bkueffle/Talking-clock/(commit log)

2018-11-02 Added LCD object and LCD interrupts
2018-11-04 Added debouncer for the clock setting buttons.
2018-11-06 added mp3 testing file and mandarin/english sound files
    -added mp3testing file
    -added mandarin sound files
    -added english mp3 files used in speech testing (not sure if .wav files will work)
    -included an excel file for keeping track of the sound file names
    [mp3filelabels.xlsx]
2018-11-12 Refactored mp3testingfile.ino into timetomp3.h/.cpp.
    - Created runtime mode changing button.
    - In the middle of making the LCD display characters for each mode during mode switching.
    - The input device still needs to be improved to be less sensitive to loud human voices.
    - Optional goal, add EEPROM memory of hours and minutes after power off (Must do a round robin write to memory, to prevent EEPROM destruction over time).
    [talking_clock.ino, timetomp3.cpp]
